danieldeesousa/Esperto-Firmware/Esperto_V3/Firmware/in_progress.jpg

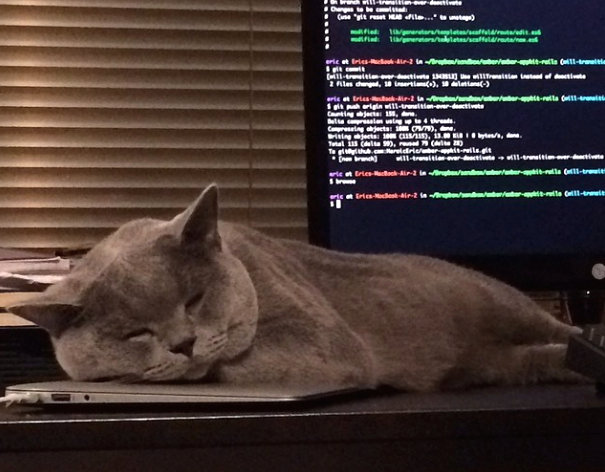
Esperto_V3/Firmware/in_progress.jpg
