danieldeesousa/Esperto-Firmware/README.md

# Esperto-Labs
Esperto Watch firmware and hardware
