danieldeesousa/Esperto-Firmware/Esperto_V3/Hardware/Esperto_Watch_V3.pdf

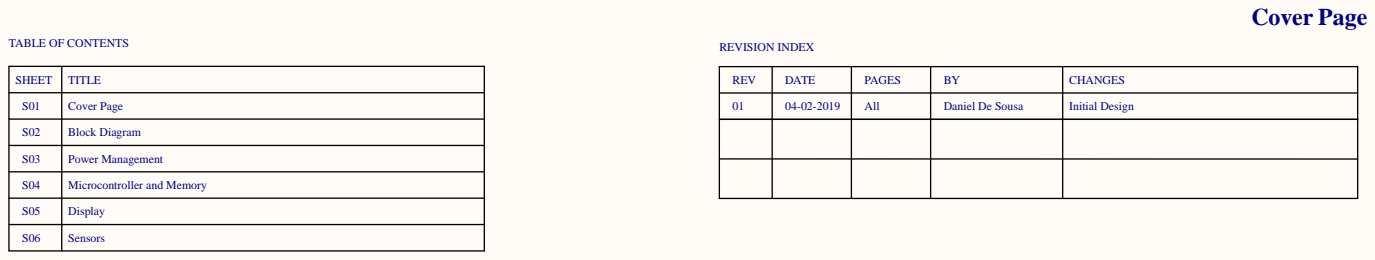
[picture p38: page 1]

S02 | Block Diagram

S03 | Power Management

S04 | Microcontroller and Memory

S05 | Display

S06 | Sensors

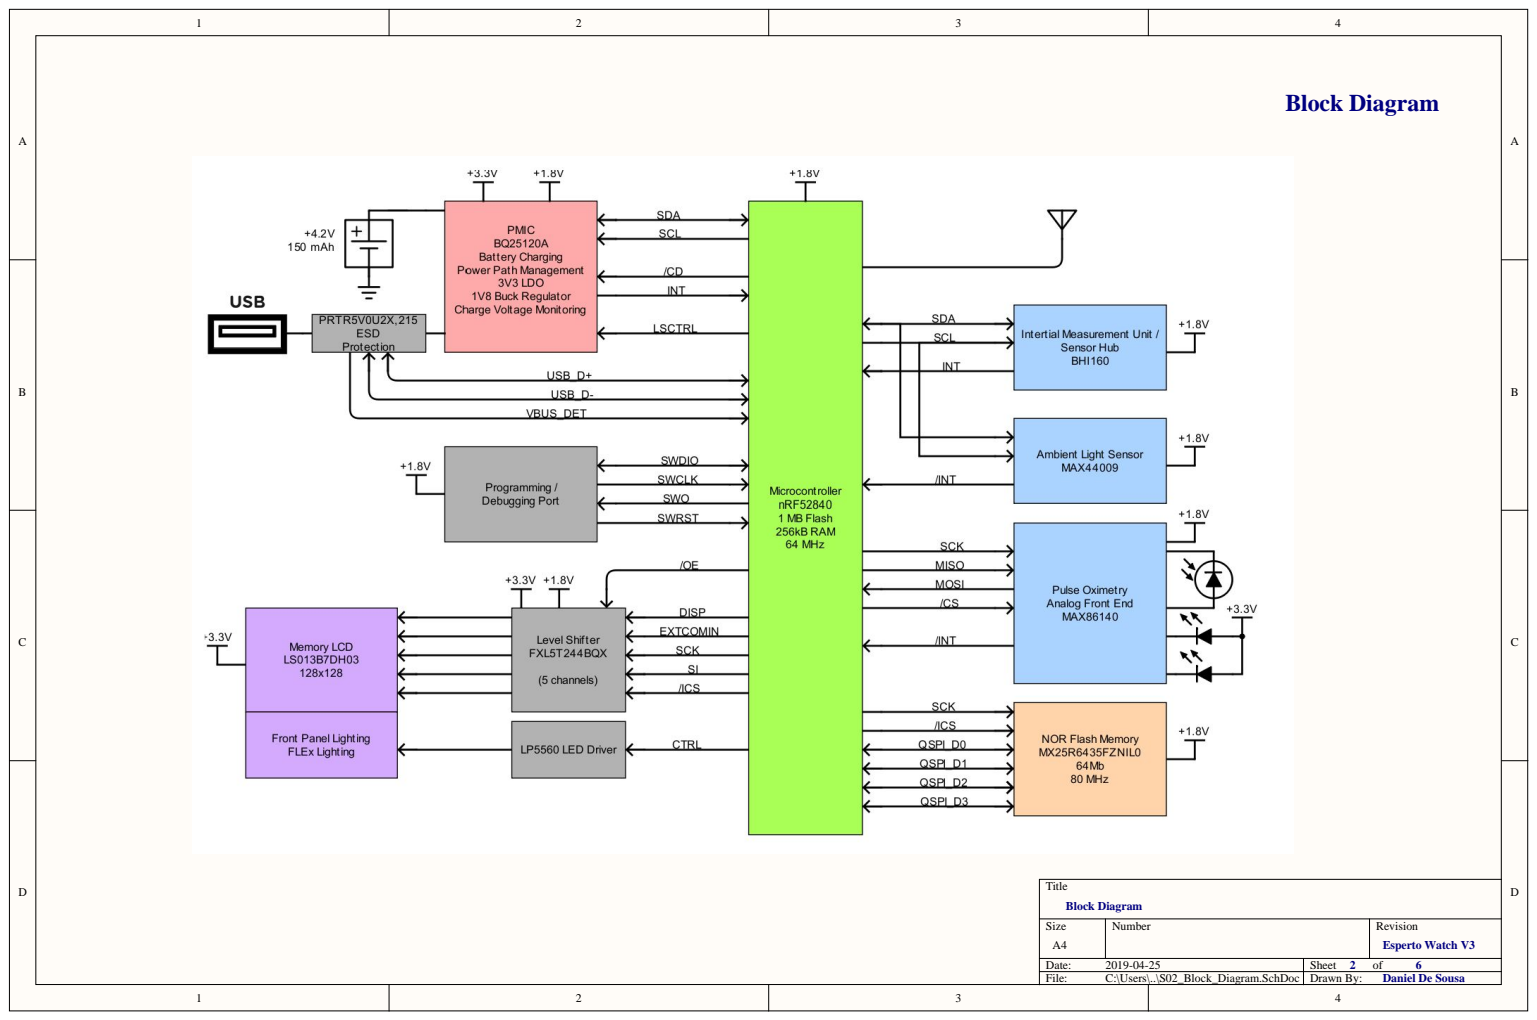
[picture p39: page 2]

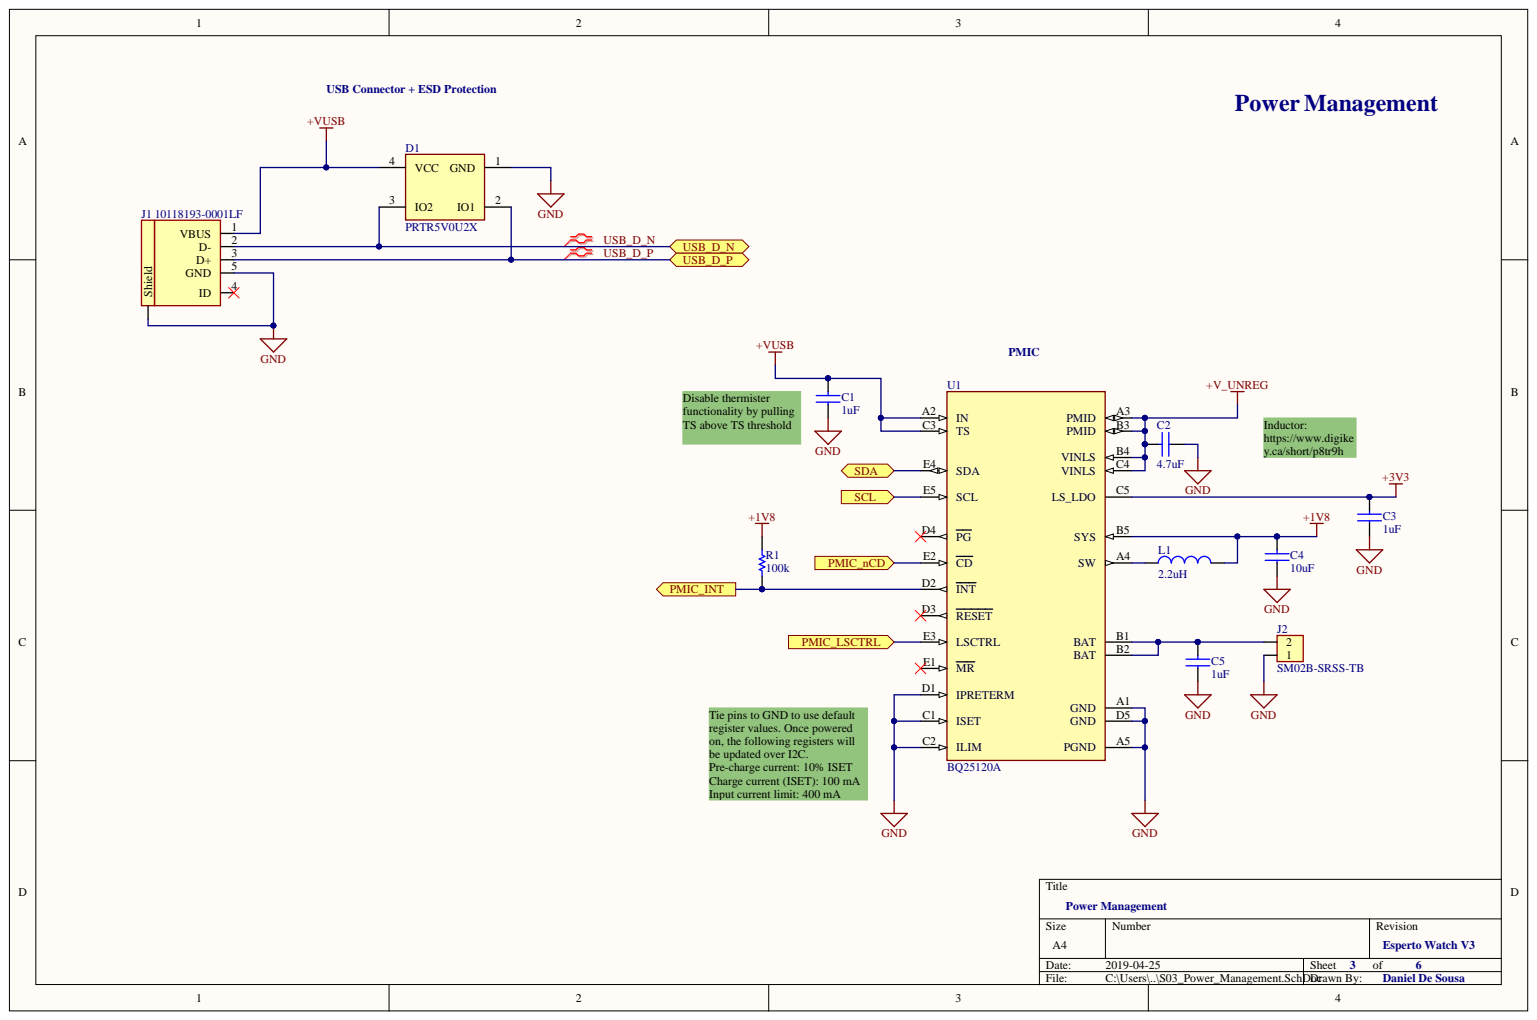
[picture p40: page 3]

USB Connector + ESD Protection

VBUS D-D+

GND ID | 4

Disable thermister
functionality by pulling
TS above TS threshold

Inductor:
https://www.digike y.ca/short/p8tr9h

Tie pins to GND to use default
register values. Once powered
on, the following registers will
be updated over I2C.
Pre-charge current: 10% ISET
Charge current (ISET): 100 mA
Input current limit: 400 mA

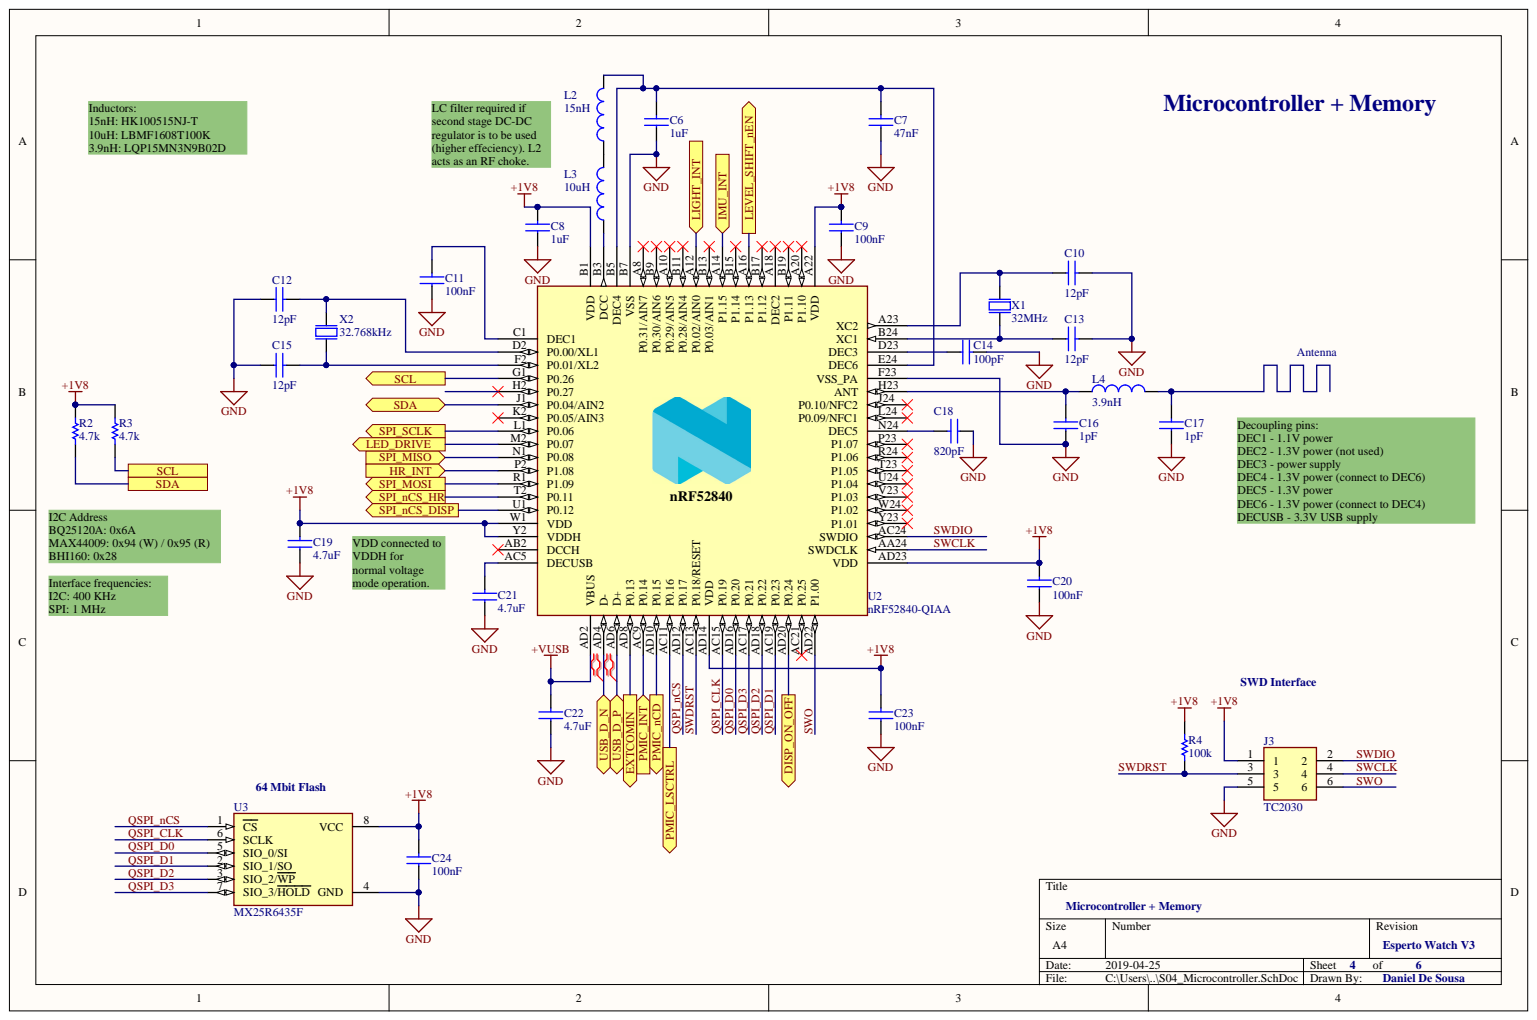
[picture p41: page 4]

LC filter required if
second stage DC-DC
regulator is to be used
(higher effeciency). L2
acts as an RF choke.

P0.27 H2 | GND
P0.04/AIN2 J1 | C18

VDDH Y2

VDD connected to VDDH for normal voltage mode operation. | DCCH AB2 | SWCLK

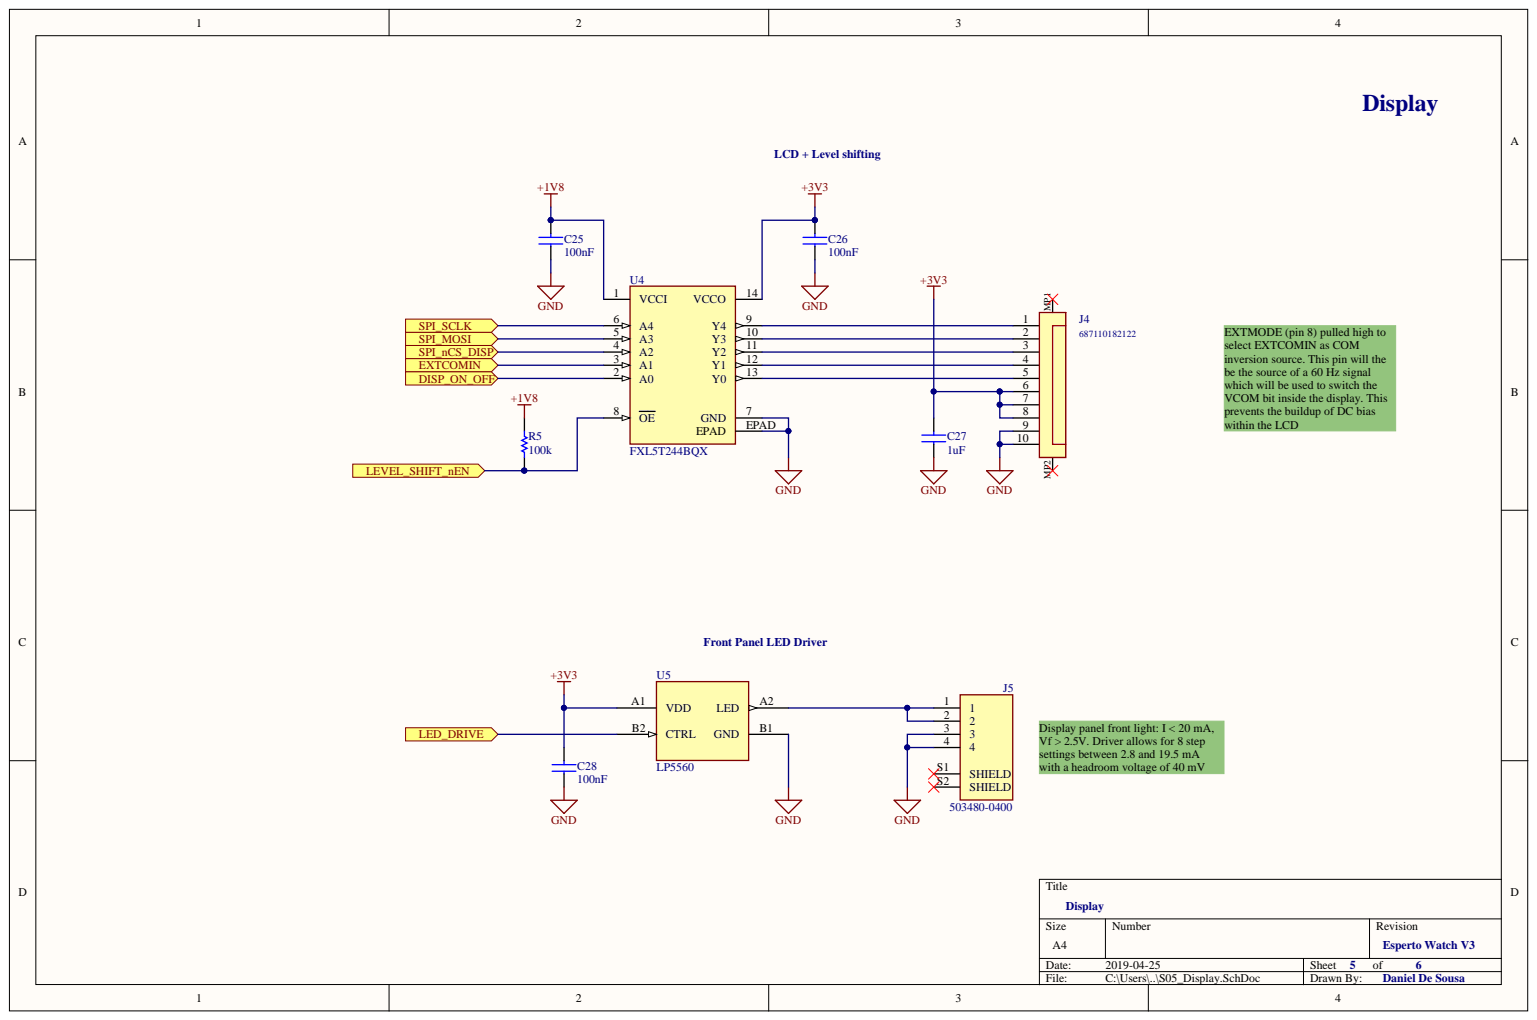
[picture p42: page 5]

EXTMODE (pin 8) pulled high to
select EXTCOMIN as COM
inversion source. This pin will the
be the source of a 60 Hz signal
which will be used to switch the
VCOM bit inside the display. This
prevents the buildup of DC bias
within the LCD

Front Panel LED Driver

Display panel front light: I < 20 mA,
Vf > 2.5V. Driver allows for 8 step
settings between 2.8 and 19.5 mA
with a headroom voltage of 40 mV

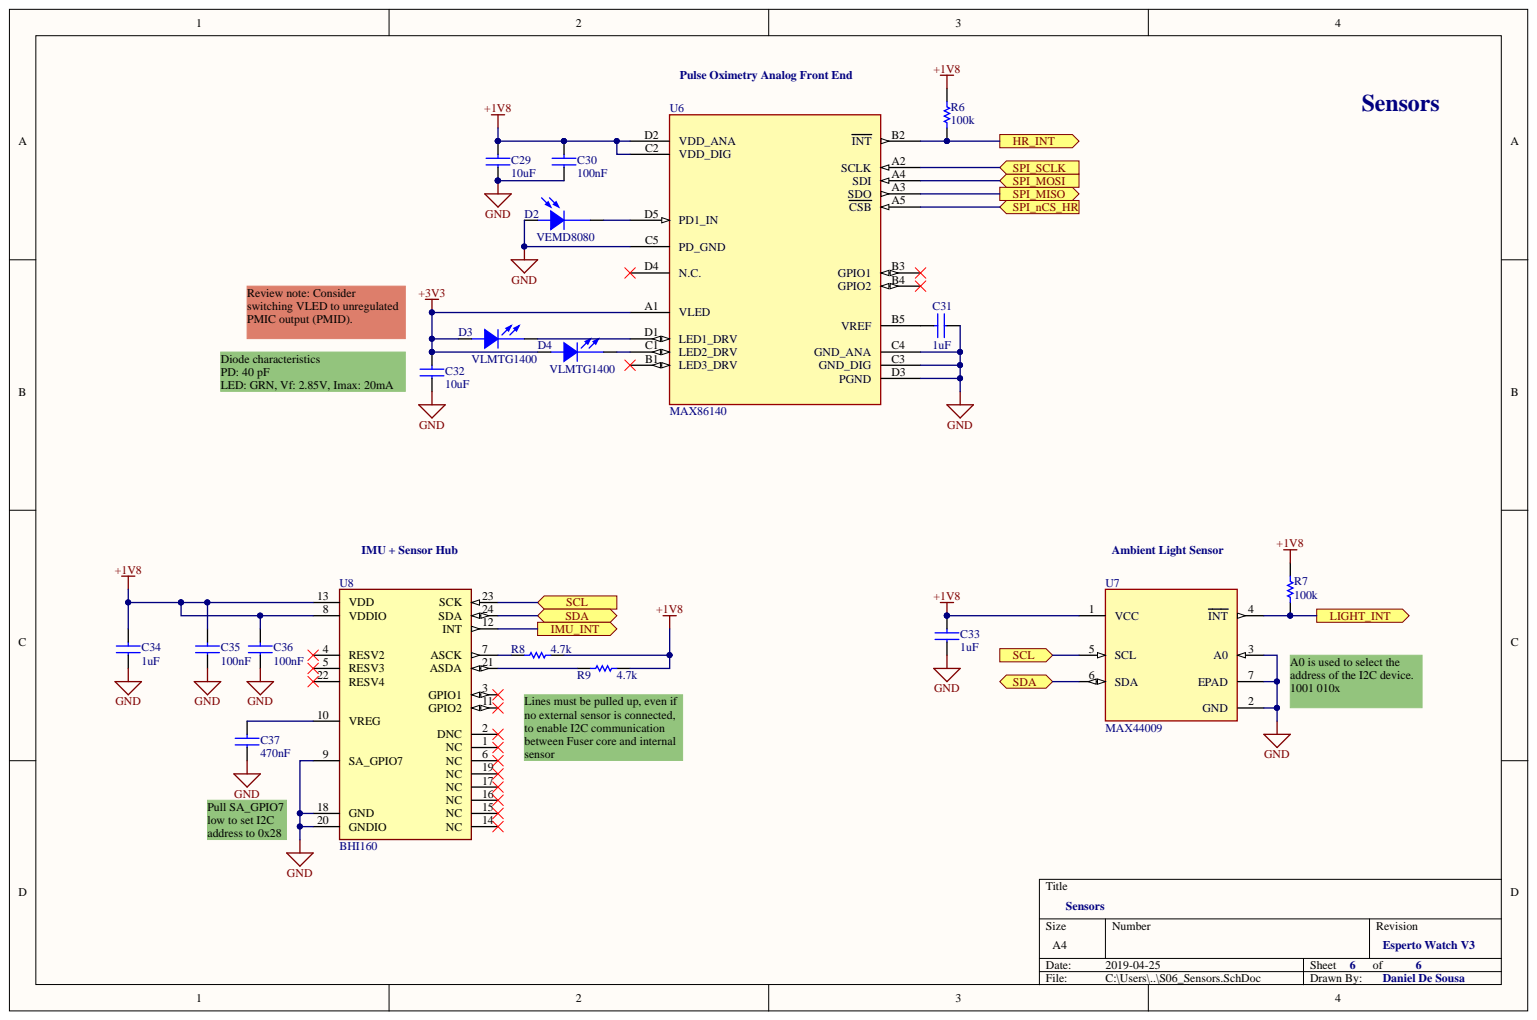
[picture p43: page 6]

Pulse Oximetry Analog Front End

Review note: Consider
switching VLED to unregulated
PMIC output (PMID).

LED1_DRV D1

Diode characteristics
LED: GRN, Vf: 2.85V, Imax: 20mA

D4 | LED2_DRV C1

A0 is used to select the
address of the I2C device.

no external sensor is connected,
to enable I2C communication
between Fuser core and internal
sensor

SA_GPIO7 9

GNDIO 20
