danieldeesousa/Esperto-Firmware/(list of files, drawings)

Other design files:
Esperto_V3/Hardware/Altium Files/Esperto_Watch_V3.PcbDoc
Esperto_V3/Hardware/Altium Files/Esperto_Watch_V3.PrjPCB
Esperto_V3/Hardware/Altium Files/S01_Cover.SchDoc
Esperto_V3/Hardware/Altium Files/S02_Block_Diagram.SchDoc
Esperto_V3/Hardware/Altium Files/S03_Power_Management.SchDoc
Esperto_V3/Hardware/Altium Files/S04_Microcontroller.SchDoc
Esperto_V3/Hardware/Altium Files/S05_Display.SchDoc
Esperto_V3/Hardware/Altium Files/S06_Sensors.SchDoc
