danieldeesousa/Esperto-Firmware/Esperto_V2/Hardware/espertowatch_v2.brd

## EAGLE design Esperto_V2/Hardware/espertowatch_v2.brd (2018-08-31, an earlier design)

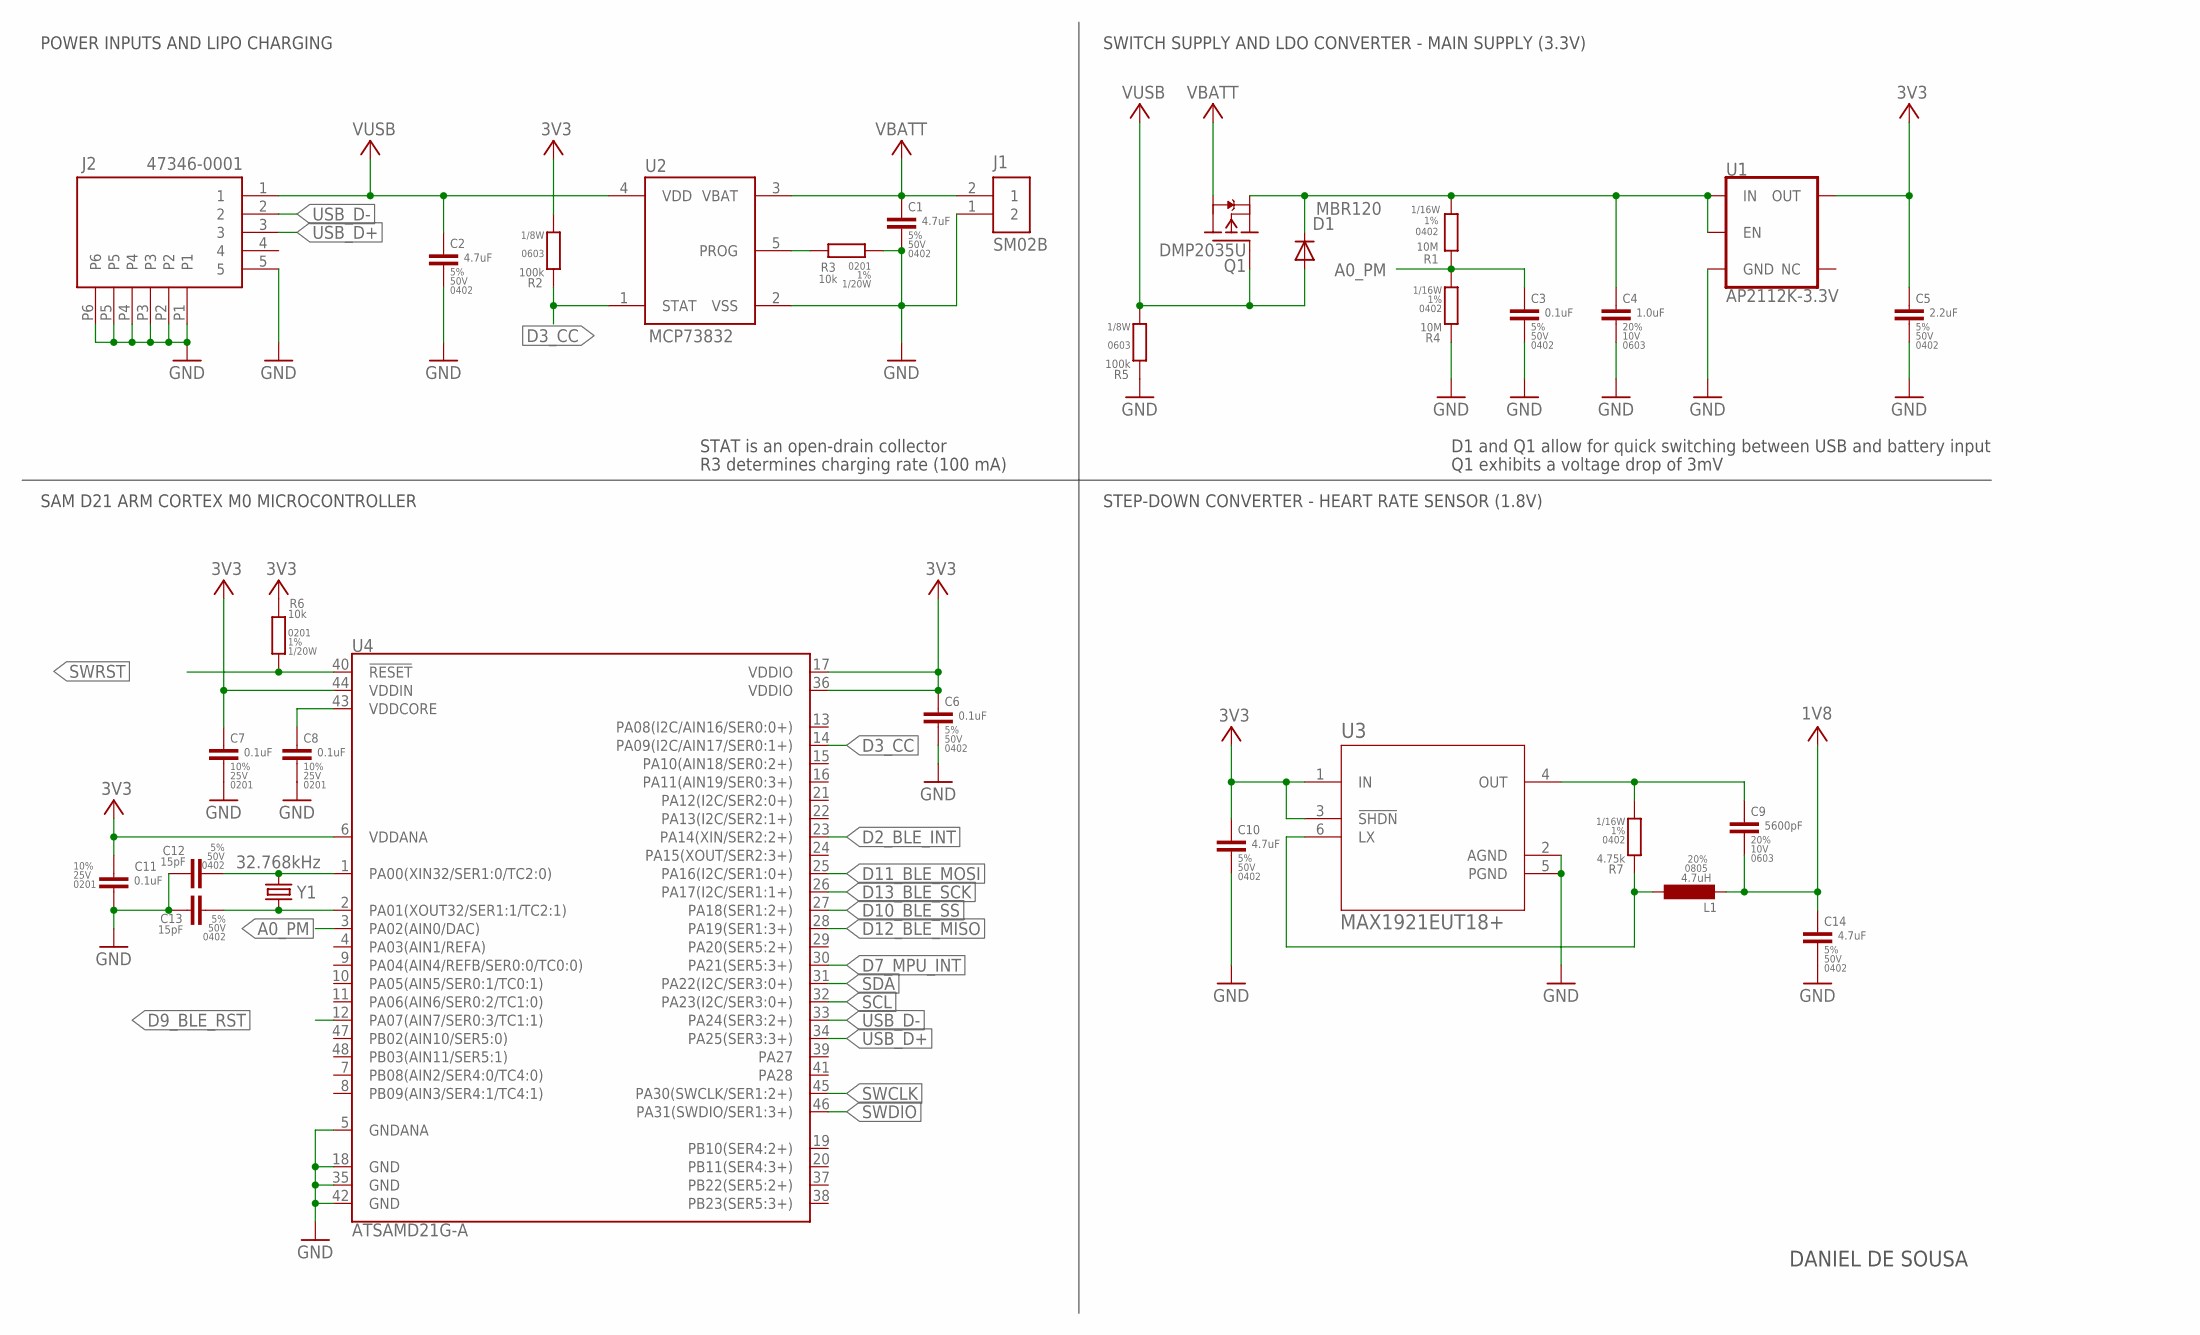
[picture p44: schematic espertowatch_v2.sch, sheet 1]

Parts:
C1, C2, C10, C14: 4.7uF; C0402_MURATA_GRM15-GJM15
C3, C6: 0.1uF; C0402_MURATA_GRM15-GJM15
C4: 1.0uF; C0603_MURATA_GRM18
C5: 2.2uF; C0402_MURATA_GRM15-GJM15
C7, C8, C11: 0.1uF; C0201_MURATA_GRM03
C9: 5600pF; C0603_MURATA_GRM18
C12, C13: 15pF; C0402_MURATA_GRM15-GJM15
D1: MBR120; SOD-123FL
J1: SM02B; JST_SH_2X1
J2: 47346-0001; MICRO_USB
L1: 4.7uH; L0805_TDK_MLZ
Q1: DMP2035U; SOT23
R1, R4: 10M; R0402_VISHAY_CRCW0402
R2, R5: 100k; R0603_VISHAY_MCT0603
R3, R6: 10k; R0201_VISHAY_CRCW0201
R7: 4.75k; R0402_VISHAY_CRCW0402
U1: AP2112K-3.3V; SOT23-5
U2: MCP73832; SOT-23
U3: MAX1921EUT18+; 21-0058I
U4: ATSAMD21G-A; TQFP-48
Y1: 32.768kHz; CRYSTAL-SMD-3.2X1.5MM

Connections:
1V8: C9.2, C14.1, L1.P$2 (2); also elsewhere on the board
3V3: C5.1, C6.1, C7.1, C10.1, C11.1, R2.2, R6.1, U1.5 (OUT), U3.1 (IN), U3.3 (!SHDN), U4.6 (VDDANA), U4.17 (VDDIO), U4.36 (VDDIO), U4.44 (VDDIN); also elsewhere on the board
A0_PM: C3.1, R1.1, R4.2, U4.3 (PA02(AIN0/DAC))
D2_BLE_INT: U4.23 (PA14(XIN/SER2:2+)); also elsewhere on the board
D3_CC: R2.1, U2.1 (STAT), U4.14 (PA09(I2C/AIN17/SER0:1+))
D7_MPU_INT: U4.30 (PA21(SER5:3+)); also elsewhere on the board
D9_BLE_RST: U4.12 (PA07(AIN7/SER0:3/TC1:1)); also elsewhere on the board
D10_BLE_SS: U4.27 (PA18(SER1:2+)); also elsewhere on the board
D11_BLE_MOSI: U4.25 (PA16(I2C/SER1:0+)); also elsewhere on the board
D12_BLE_MISO: U4.28 (PA19(SER1:3+)); also elsewhere on the board
D13_BLE_SCK: U4.26 (PA17(I2C/SER1:1+)); also elsewhere on the board
GND: C1.2, C2.2, C3.2, C4.2, C5.2, C6.2, C7.2, C8.2, C10.2, C11.2, C12.1, C13.1, C14.2, J1.1 (2), J2.5, J2.P1, J2.P2, J2.P3, J2.P4, J2.P5, J2.P6, R3.2, R4.1, R5.1, U1.2 (GND), U2.2 (VSS), U3.2 (AGND), U3.5 (PGND), U4.5 (GNDANA), U4.18 (GND), U4.35 (GND), U4.42 (GND); also elsewhere on the board
unnamed: C4.1, D1.C, Q1.E (S), R1.2, U1.1 (IN), U1.3 (EN)
unnamed: R3.1, U2.5 (PROG)
unnamed: C8.1, U4.43 (VDDCORE)
unnamed: C12.2, U4.1 (PA00(XIN32/SER1:0/TC2:0)), Y1.P$2 (2)
unnamed: C13.2, U4.2 (PA01(XOUT32/SER1:1/TC2:1)), Y1.P$1 (1)
unnamed: L1.P$1 (1), R7.1, U3.6 (LX)
unnamed: C9.1, R7.2, U3.4 (OUT)
SCL: U4.32 (PA23(I2C/SER3:0+)); also elsewhere on the board
SDA: U4.31 (PA22(I2C/SER3:0+)); also elsewhere on the board
SWCLK: U4.45 (PA30(SWCLK/SER1:2+)); also elsewhere on the board
SWDIO: U4.46 (PA31(SWDIO/SER1:3+)); also elsewhere on the board
SWRST: R6.2, U4.40 (!RESET!); also elsewhere on the board
USB_D+: J2.3, U4.34 (PA25(SER3:3+))
USB_D-: J2.2, U4.33 (PA24(SER3:2+))
VBATT: C1.1, J1.2 (1), Q1.C (D), U2.3 (VBAT)
VUSB: C2.1, D1.A, J2.1, Q1.B (G), R5.2, U2.4 (VDD)

Notes on the sheet:
SAM D21 ARM CORTEX M0 MICROCONTROLLER
STEP-DOWN CONVERTER - HEART RATE SENSOR (1.8V)
POWER INPUTS AND LIPO CHARGING
SWITCH SUPPLY AND LDO CONVERTER - MAIN SUPPLY (3.3V)
STAT is an open-drain collector
R3 determines charging rate (100 mA)
D1 and Q1 allow for quick switching between USB and battery input
DANIEL DE SOUSA
Q1 exhibits a voltage drop of 3mV

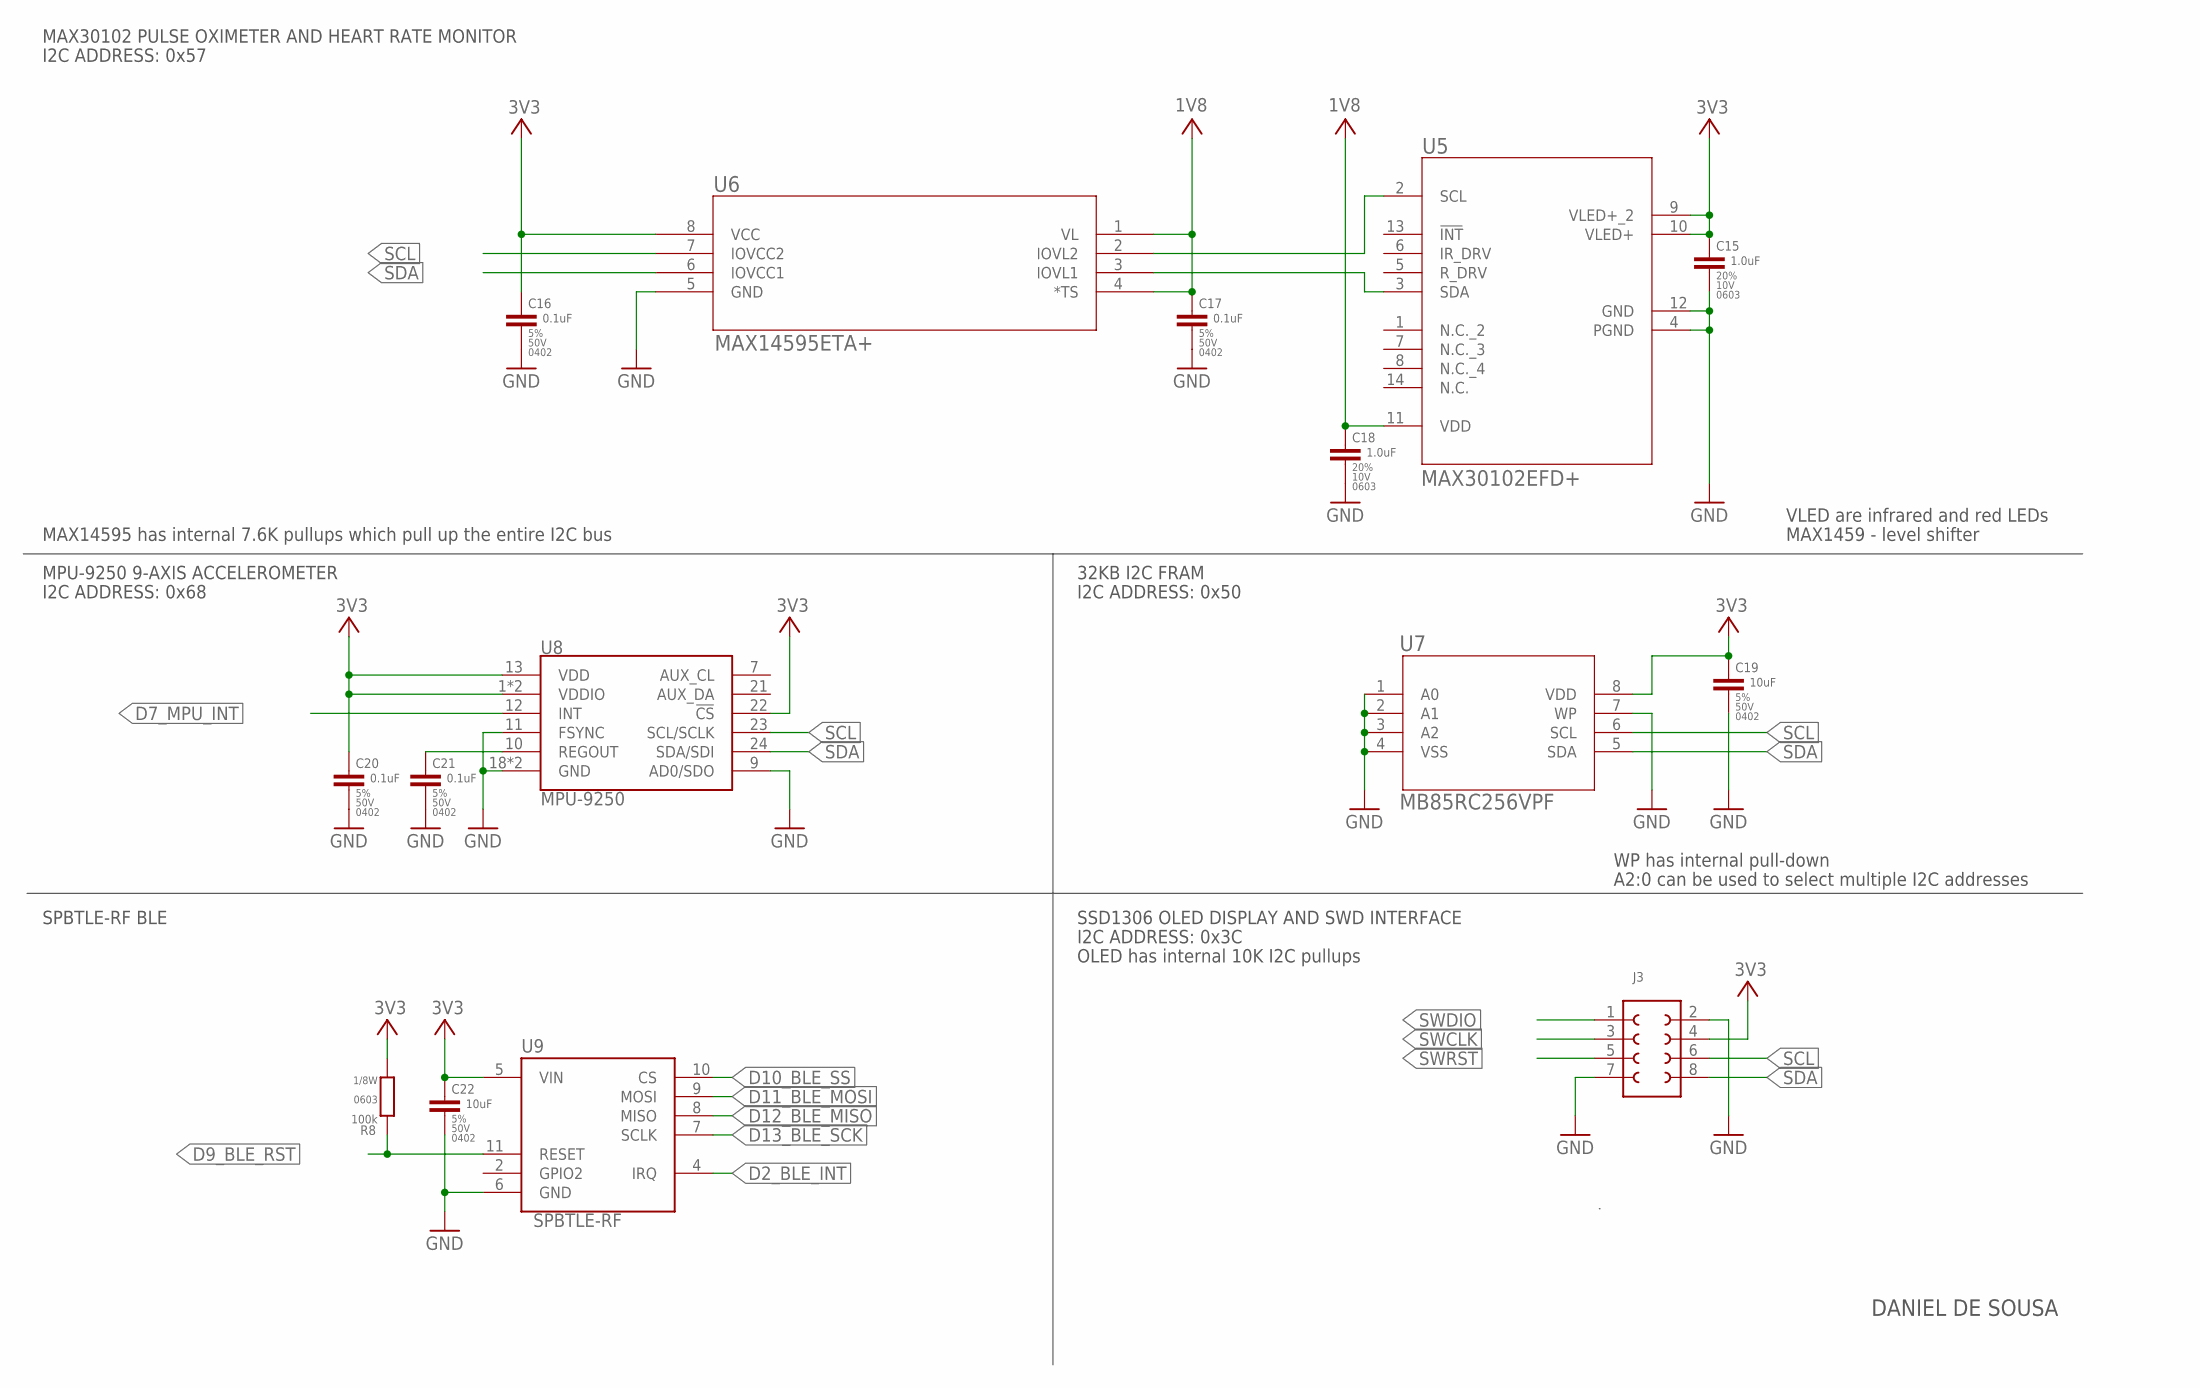
[picture p45: schematic espertowatch_v2.sch, sheet 2]

Parts:
C15, C18: 1.0uF; C0603_MURATA_GRM18
C16, C17, C20, C21: 0.1uF; C0402_MURATA_GRM15-GJM15
C19, C22: 10uF; C0402_MURATA_GRM15-GJM15
J3: 610X08243021
R8: 100k; R0603_VISHAY_MCT0603
U5: MAX30102EFD+; 21-0880B-M
U6: MAX14595ETA+; 21-0487A
U7: MB85RC256VPF; FPT-8P-M02
U8: MPU-9250; QFN24-3X3
U9: SPBTLE-RF

Connections:
1V8: C17.1, C18.1, U5.11 (VDD), U6.1 (VL), U6.4 (*TS); also elsewhere on the board
3V3: C15.1, C16.1, C19.1, C20.1, C22.1, J3.4 (7), R8.2, U5.9 (VLED+_2), U5.10 (VLED+), U6.8 (VCC), U7.8 (VDD), U8.1 (VDDIO), U8.8 (VDDIO), U8.13 (VDD), U8.22 (!CS), U9.5 (VIN); also elsewhere on the board
D2_BLE_INT: U9.4 (IRQ); also elsewhere on the board
D7_MPU_INT: U8.12 (INT); also elsewhere on the board
D9_BLE_RST: R8.1, U9.11 (RESET); also elsewhere on the board
D10_BLE_SS: U9.10 (CS); also elsewhere on the board
D11_BLE_MOSI: U9.9 (MOSI); also elsewhere on the board
D12_BLE_MISO: U9.8 (MISO); also elsewhere on the board
D13_BLE_SCK: U9.7 (SCLK); also elsewhere on the board
GND: C15.2, C16.2, C17.2, C18.2, C19.2, C20.2, C21.2, C22.2, J3.2 (8), J3.7 (4), U5.4 (PGND), U5.12 (GND), U6.5 (GND), U7.1 (A0), U7.2 (A1), U7.3 (A2), U7.4 (VSS), U7.7 (WP), U8.9 (AD0/SDO), U8.11 (FSYNC), U8.18 (GND), U8.20 (GND), U9.6 (GND); also elsewhere on the board
unnamed: C21.1, U8.10 (REGOUT)
unnamed: U5.2 (SCL), U6.2 (IOVL2)
unnamed: U5.3 (SDA), U6.3 (IOVL1)
SCL: J3.6, U6.7 (IOVCC2), U7.6 (SCL), U8.23 (SCL/SCLK); also elsewhere on the board
SDA: J3.8 (5), U6.6 (IOVCC1), U7.5 (SDA), U8.24 (SDA/SDI); also elsewhere on the board
SWCLK: J3.3 (2); also elsewhere on the board
SWDIO: J3.1; also elsewhere on the board
SWRST: J3.5 (3); also elsewhere on the board

Notes on the sheet:
32KB I2C FRAM
SPBTLE-RF BLE
MPU-9250 9-AXIS ACCELEROMETER
MAX30102 PULSE OXIMETER AND HEART RATE MONITOR
SSD1306 OLED DISPLAY AND SWD INTERFACE
VLED are infrared and red LEDs
MAX1459 - level shifter
WP has internal pull-down
A2:0 can be used to select multiple I2C addresses
DANIEL DE SOUSA
MAX14595 has internal 7.6K pullups which pull up the entire I2C bus
OLED has internal 10K I2C pullups
I2C ADDRESS: 0x3C
I2C ADDRESS: 0x50
I2C ADDRESS: 0x68
I2C ADDRESS: 0x57

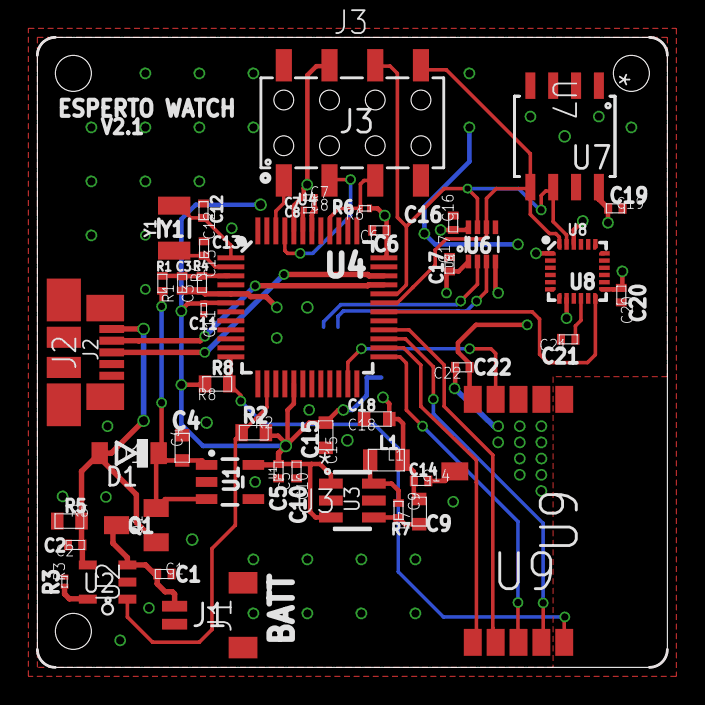
[picture p46: board espertowatch_v2.brd from above]

Board: 2 copper layers, 35.0 x 35.0 mm, 46 parts (1 on the bottom side), 31 nets.
