danieldeesousa/Esperto-Firmware/Esperto_V1/Hardware/esperto_v1.brd

## EAGLE design Esperto_V1/Hardware/esperto_v1.brd (2018-06-21, an earlier design)

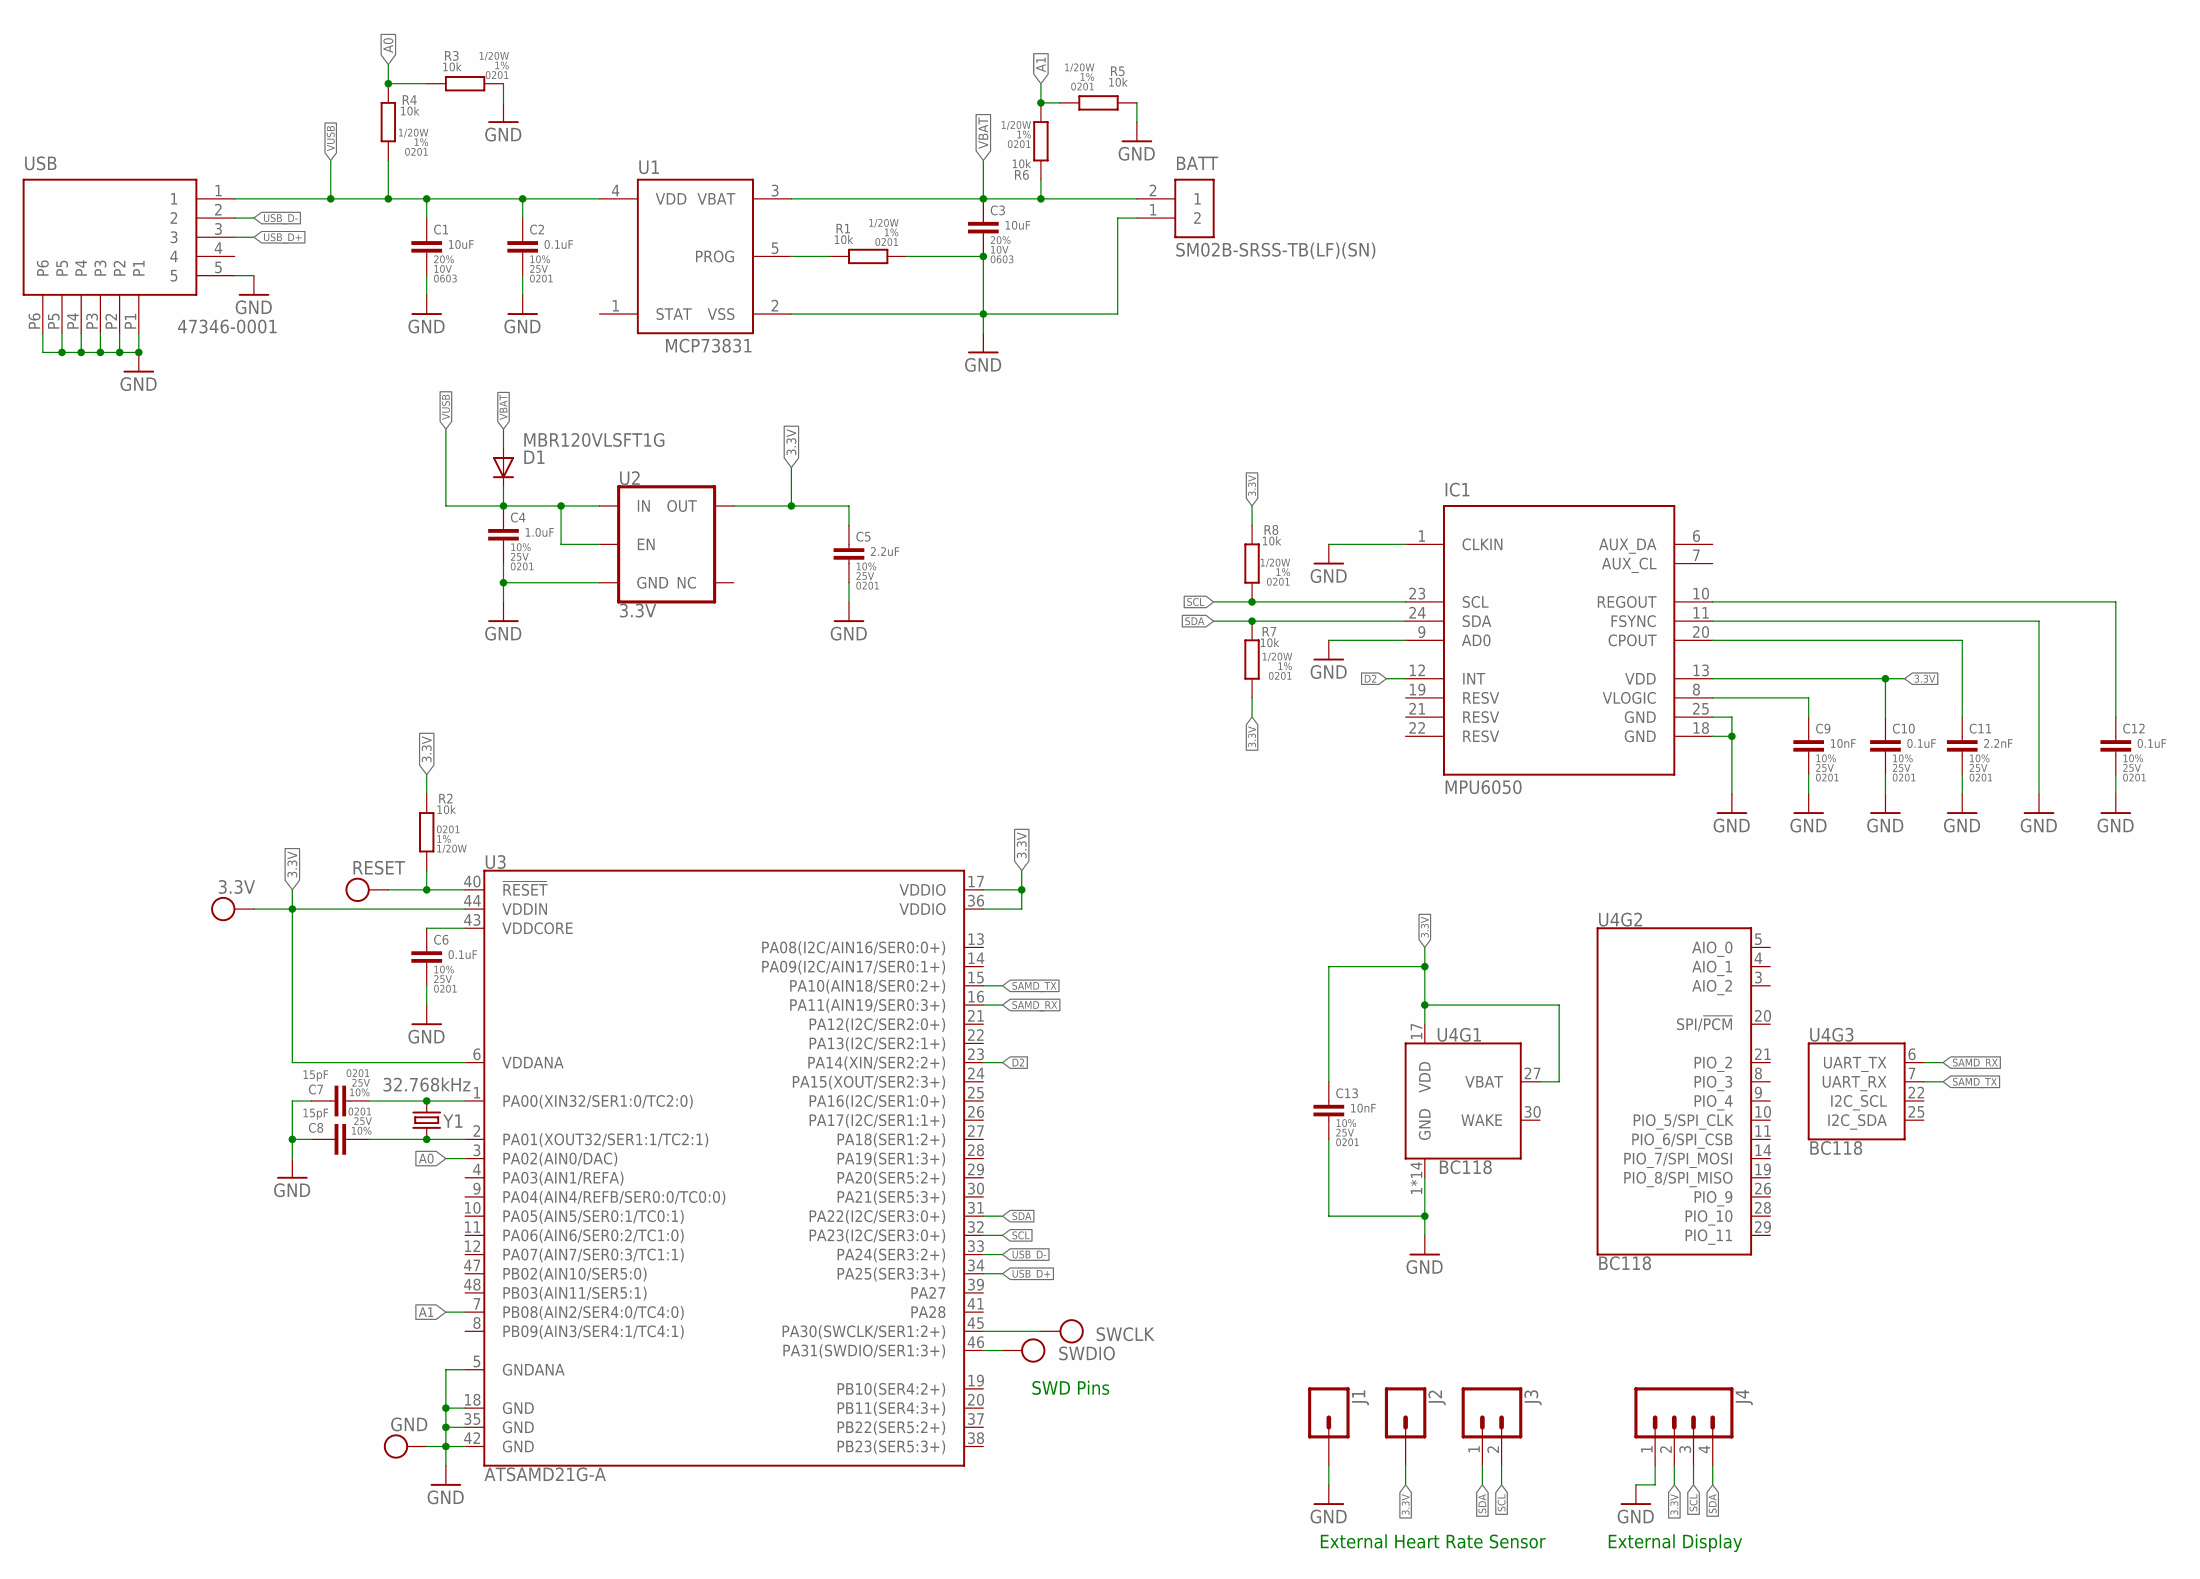
[picture p47: schematic esperto_v1.sch]

Parts:
3.3V: PIN_1X.05"1; 1X.05"
BATT: SM02B-SRSS-TB(LF)(SN); JST_SH_2X1
C1, C3: 10uF; C0603_MURATA_GRM18
C2, C6, C10, C12: 0.1uF; C0201_MURATA_GRM03
C4: 1.0uF; C0201_MURATA_GRM03
C5: 2.2uF; C0201_MURATA_GRM03
C7, C8: 15pF; C0201_MURATA_GRM03
C9, C13: 10nF; C0201_MURATA_GRM03
C11: 2.2nF; C0201_MURATA_GRM03
D1: MBR120VLSFT1G; SOD-123FL
GND: PIN_1X.05"1; 1X.05"
IC1: MPU6050; QFN50P400X400X95-25T265X275N
J1, J2: CONN_01; 1X01
J3: CONN_02; 1X02
J4: CONN_04; 1X04
R1, R2, R3, R4, R5, R6, R7, R8: 10k; R0201_VISHAY_CRCW0201
RESET: PIN_1X.05"1; 1X.05"
SWCLK: PIN_1X.05"1; 1X.05"
SWDIO: PIN_1X.05"1; 1X.05"
U1: MCP73831; SOT-23
U2: 3.3V; SOT23-5
U3: ATSAMD21G-A; TQFP-48
U4: BC118
USB: 47346-0001; MICRO_USB
Y1: 32.768kHz; CRYSTAL-SMD-3.2X1.5MM

Connections:
3.3V: 3.3V.1, C5.1, C10.1, C13.1, IC1.13 (VDD), J2.1, J4.2, R2.1, R7.2, R8.1, U2.5 (OUT), U3.6 (VDDANA), U3.17 (VDDIO), U3.36 (VDDIO), U3.44 (VDDIN), U4.17 (VDD), U4.27 (VBAT)
A0: R3.1, R4.1, U3.3 (PA02(AIN0/DAC))
A1: R5.2, R6.2, U3.7 (PB08(AIN2/SER4:0/TC4:0))
D2: IC1.12 (INT), U3.23 (PA14(XIN/SER2:2+))
GND: BATT.1 (2), C1.2, C2.2, C3.2, C4.2, C5.2, C6.2, C7.1, C8.1, C9.2, C10.2, C11.2, C12.2, C13.2, GND.1, IC1.1 (CLKIN), IC1.9 (AD0), IC1.11 (FSYNC), IC1.18 (GND), IC1.25 (GND), J1.1, J4.1, R1.2, R3.2, R5.1, U1.2 (VSS), U2.2 (GND), U3.5 (GNDANA), U3.18 (GND), U3.35 (GND), U3.42 (GND), U4.1 (GND), U4.2 (GND), U4.12 (GND), U4.13 (GND), U4.15 (GND), U4.16 (GND), U4.18 (GND), U4.23 (GND), U4.24 (GND), U4.31 (GND), U4.32 (GND), U4.33 (GND), U4.34 (GND), U4.35 (GND), USB.5, USB.P1, USB.P2, USB.P3, USB.P4, USB.P5, USB.P6
unnamed: R1.1, U1.5 (PROG)
unnamed: R2.2, RESET.1, U3.40 (!RESET!)
unnamed: C6.1, U3.43 (VDDCORE)
unnamed: C7.2, U3.1 (PA00(XIN32/SER1:0/TC2:0)), Y1.P$1 (1)
unnamed: C8.2, U3.2 (PA01(XOUT32/SER1:1/TC2:1)), Y1.P$2 (2)
unnamed: SWCLK.1, U3.45 (PA30(SWCLK/SER1:2+))
unnamed: SWDIO.1, U3.46 (PA31(SWDIO/SER1:3+))
unnamed: C9.1, IC1.8 (VLOGIC)
unnamed: C11.1, IC1.20 (CPOUT)
unnamed: C12.1, IC1.10 (REGOUT)
SAMD_RX: U3.16 (PA11(AIN19/SER0:3+)), U4.6 (UART_TX)
SAMD_TX: U3.15 (PA10(AIN18/SER0:2+)), U4.7 (UART_RX)
SCL: IC1.23 (SCL), J3.2, J4.3, R8.2, U3.32 (PA23(I2C/SER3:0+))
SDA: IC1.24 (SDA), J3.1, J4.4, R7.1, U3.31 (PA22(I2C/SER3:0+))
USB_D+: U3.34 (PA25(SER3:3+)), USB.3
USB_D-: U3.33 (PA24(SER3:2+)), USB.2
VBAT: BATT.2 (1), C3.1, D1.A, R6.1, U1.3 (VBAT)
VUSB: C1.1, C2.1, C4.1, D1.C, R4.2, U1.4 (VDD), U2.1 (IN), U2.3 (EN), USB.1

Notes on the sheet:
External Heart Rate Sensor
External Display
SWD Pins

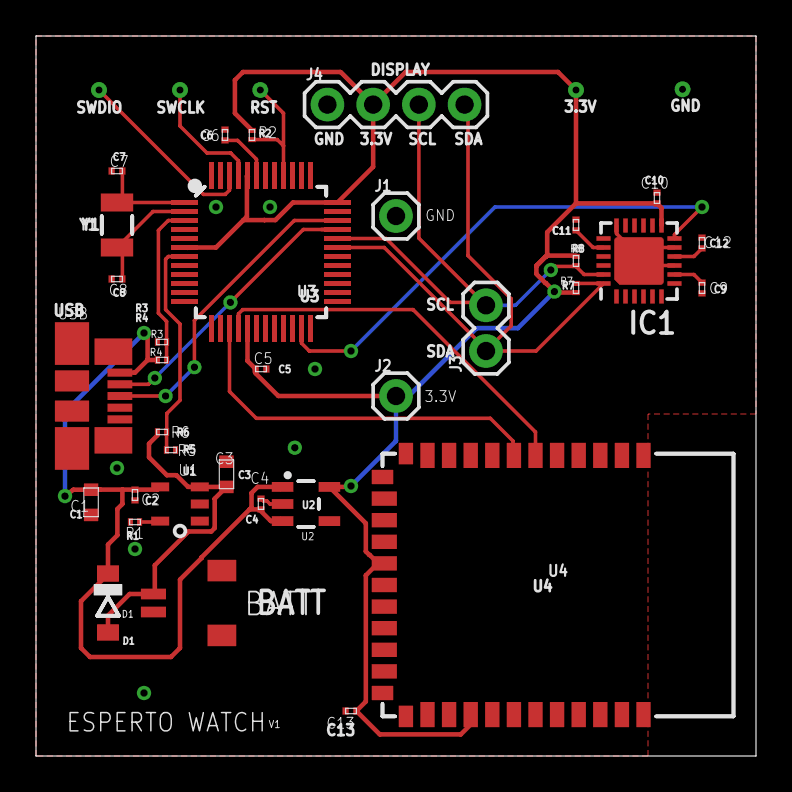
[picture p48: board esperto_v1.brd from above]

Board: 2 copper layers, 40.0 x 40.0 mm, 39 parts (0 on the bottom side), 23 nets.
