danieldeesousa/Esperto-Firmware/(commit log)

2018-02-26 Removed everything but firmware
    [Esperto_v1.0.0 BOM - Finalized(1).xlsx, Esperto_v1.0.0 BOM - Finalized.xlsx, Esperto_v1.1.0 BOM - Finalized(2).xlsx, Esperto_v1.1.0 BOM - Finalized.xlsx, Esperto_v1.1.3 BOM.xlsx, Interviews.xlsx, Smart Watch Assembly.stl, Smart Watch Bottom.stl]
2018-06-21 Added Esperto Version 2 and hardware files
    [esperto_v1.brd, esperto_v1.sch, espertowatch_v2.brd, espertowatch_v2.sch]
2018-06-24 Added new hardware and EAGLE libraries
    [espertowatch_v2.brd, espertowatch_v2.sch]
2018-07-09 BLE support for APP - bug fixes
    [espertowatch_v2.brd, espertowatch_v2.sch]
2018-07-18 Refactored timer library
2018-08-09 Added power management functionality
2018-08-16 Timer updates and refactoring
2018-08-31 Removed I2C pullups
    [espertowatch_v2.brd, espertowatch_v2.sch]
2018-09-07 Modified power management state machine
2018-09-18 Add shutdown voltage hysteresis and new logo
2019-04-25 Esperto V3 Hardware
    [Esperto_Watch_V3.PcbDoc, Esperto_Watch_V3.PrjPCB, S01_Cover.SchDoc, S02_Block_Diagram.SchDoc, S03_Power_Management.SchDoc, S04_Microcontroller.SchDoc, S05_Display.SchDoc, S06_Sensors.SchDoc]
2019-09-11 DFM issues
    [Esperto_Watch_V3.PcbDoc, Esperto_Watch_V3.PrjPCB]
