danieldeesousa/Esperto-Firmware/(notices)

Notices in the files:
parts and their libraries:
Board-to-Board: Copyright: Würth Elektronik
SparkFun-IC-Power: Licensing: Creative Commons ShareAlike 4.0 International - https://creativecommons.org/licenses/by-sa/4.0
